isabelburgos/glasgow-rgmii-adapter/design.md

## Connectors

### RJ45

| P/N | Digikey | JLC
|--|--|--|
| RJMG201K21120FR | [link](https://www.digikey.com/en/products/detail/amphenol-cs-commercial-products/RJMG201K21120FR/13683222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) | [link](https://jlcpcb.com/partdetail/AmphenolICC-RJMG201K21120FR/C3179446)

### 2x10 Pin Receptacles

| P/N | Digikey | JLC
|--|--|--|
|BCS-110-S-D-TE|[link](https://www.digikey.com/en/products/detail/samtec-inc/BCS-110-S-D-TE/6629089)|--
|B-2200S20P-B120|--|[link](https://jlcpcb.com/partdetail/125694-B_2200S20PB120/C124419)

Added the following lines to positions.csv:
```
J1A,164.0,-80.95,90.0,top
J1B,164.0,-119.05,270.0,top
```

## 25 MHz

### Oscillator
| P/N | Digikey | JLC
|--|--|--|
|SG-210STF 25.0000ML0
|OT201625MJBA4SL

### Crystal
| P/N | Digikey | JLC
|--|--|--|
|ECS-250-10-37B-CTN-TR

## Passives

### Ferrite Beads
| P/N | Digikey | JLC
|--|--|--|
|BLM18PG300SN1D|--|[link](https://jlcpcb.com/partdetail/MurataElectronics-BLM18PG300SN1D/C17305)
