isabelburgos/glasgow-rgmii-adapter/glasgow ethernet adapter/3D models/ECS-250-10-37B-CTN-TR.step

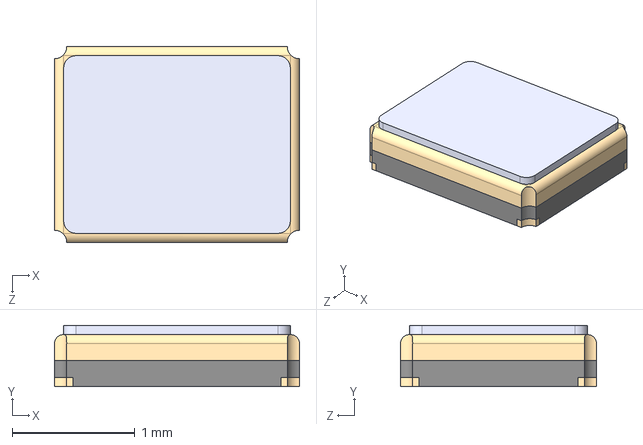
[picture p1: CAD file, 2025-06-25]
glasgow ethernet adapter/3D models/ECS-250-10-37B-CTN-TR.step
2.00 x 0.5 x 1.60 mm
