isabelburgos/glasgow-rgmii-adapter/glasgow ethernet adapter/3D models/SFH11-PBPC-D10-ST-BK.step

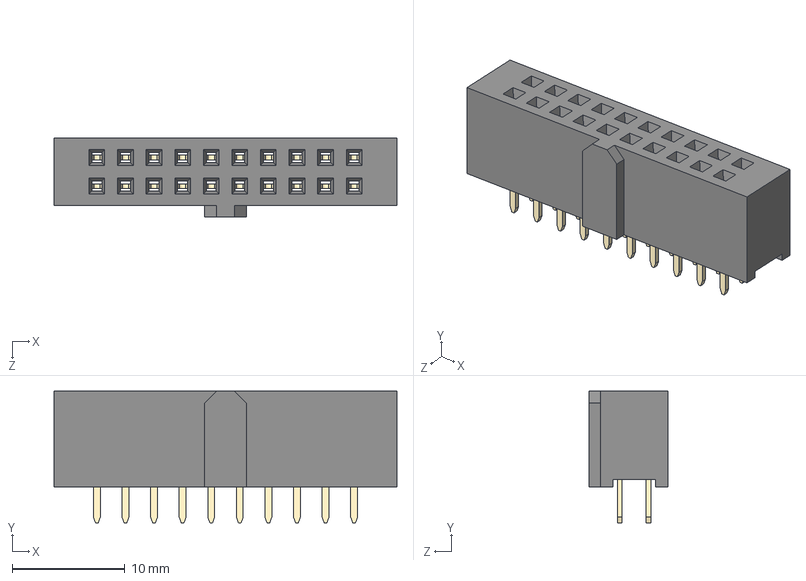
[picture p2: CAD file, 2025-06-25]
glasgow ethernet adapter/3D models/SFH11-PBPC-D10-ST-BK.step
30.5 x 11.7 x 7.01 mm
SFH11-xC-Dx-ST-BK body_10
pin^SFH11-xC-Dx-ST-BK Ass x 20
