isabelburgos/glasgow-rgmii-adapter/glasgow ethernet adapter/3D models/RJMG1S8008101BR.step

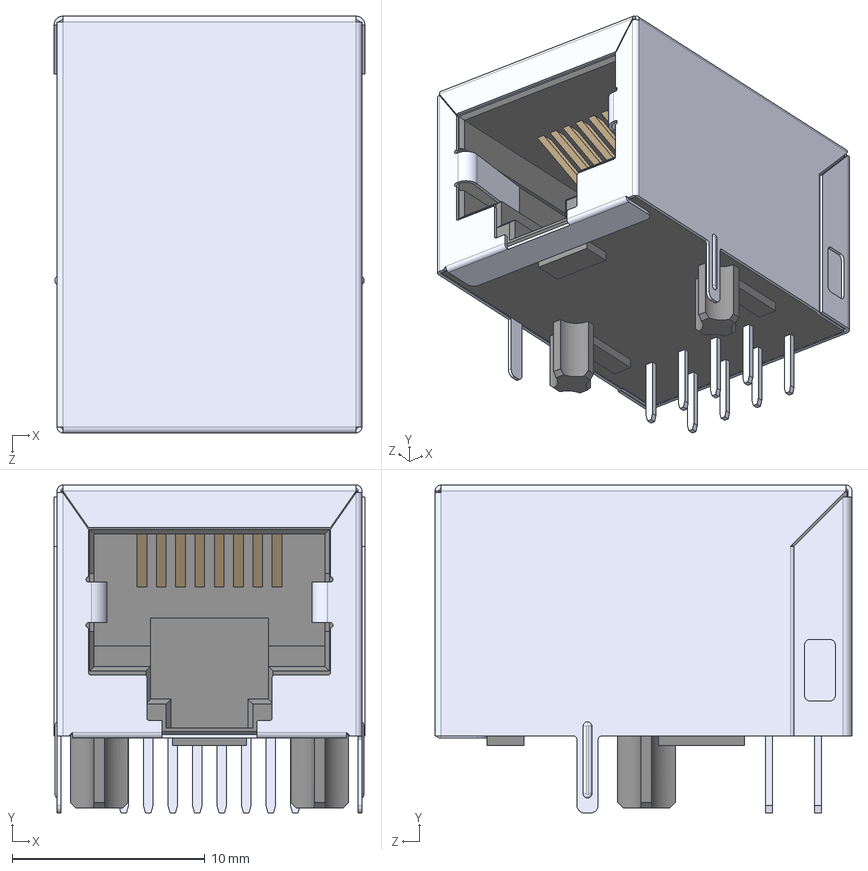
[picture p3: CAD file, 2025-06-25]
glasgow ethernet adapter/3D models/RJMG1S8008101BR.step
16.1 x 17.0 x 21.6 mm
