isabelburgos/glasgow-rgmii-adapter/glasgow ethernet adapter/glasgow ethernet adapter.kicad_pcb

## KiCad design glasgow ethernet adapter/glasgow ethernet adapter.kicad_pcb (2025-07-08)

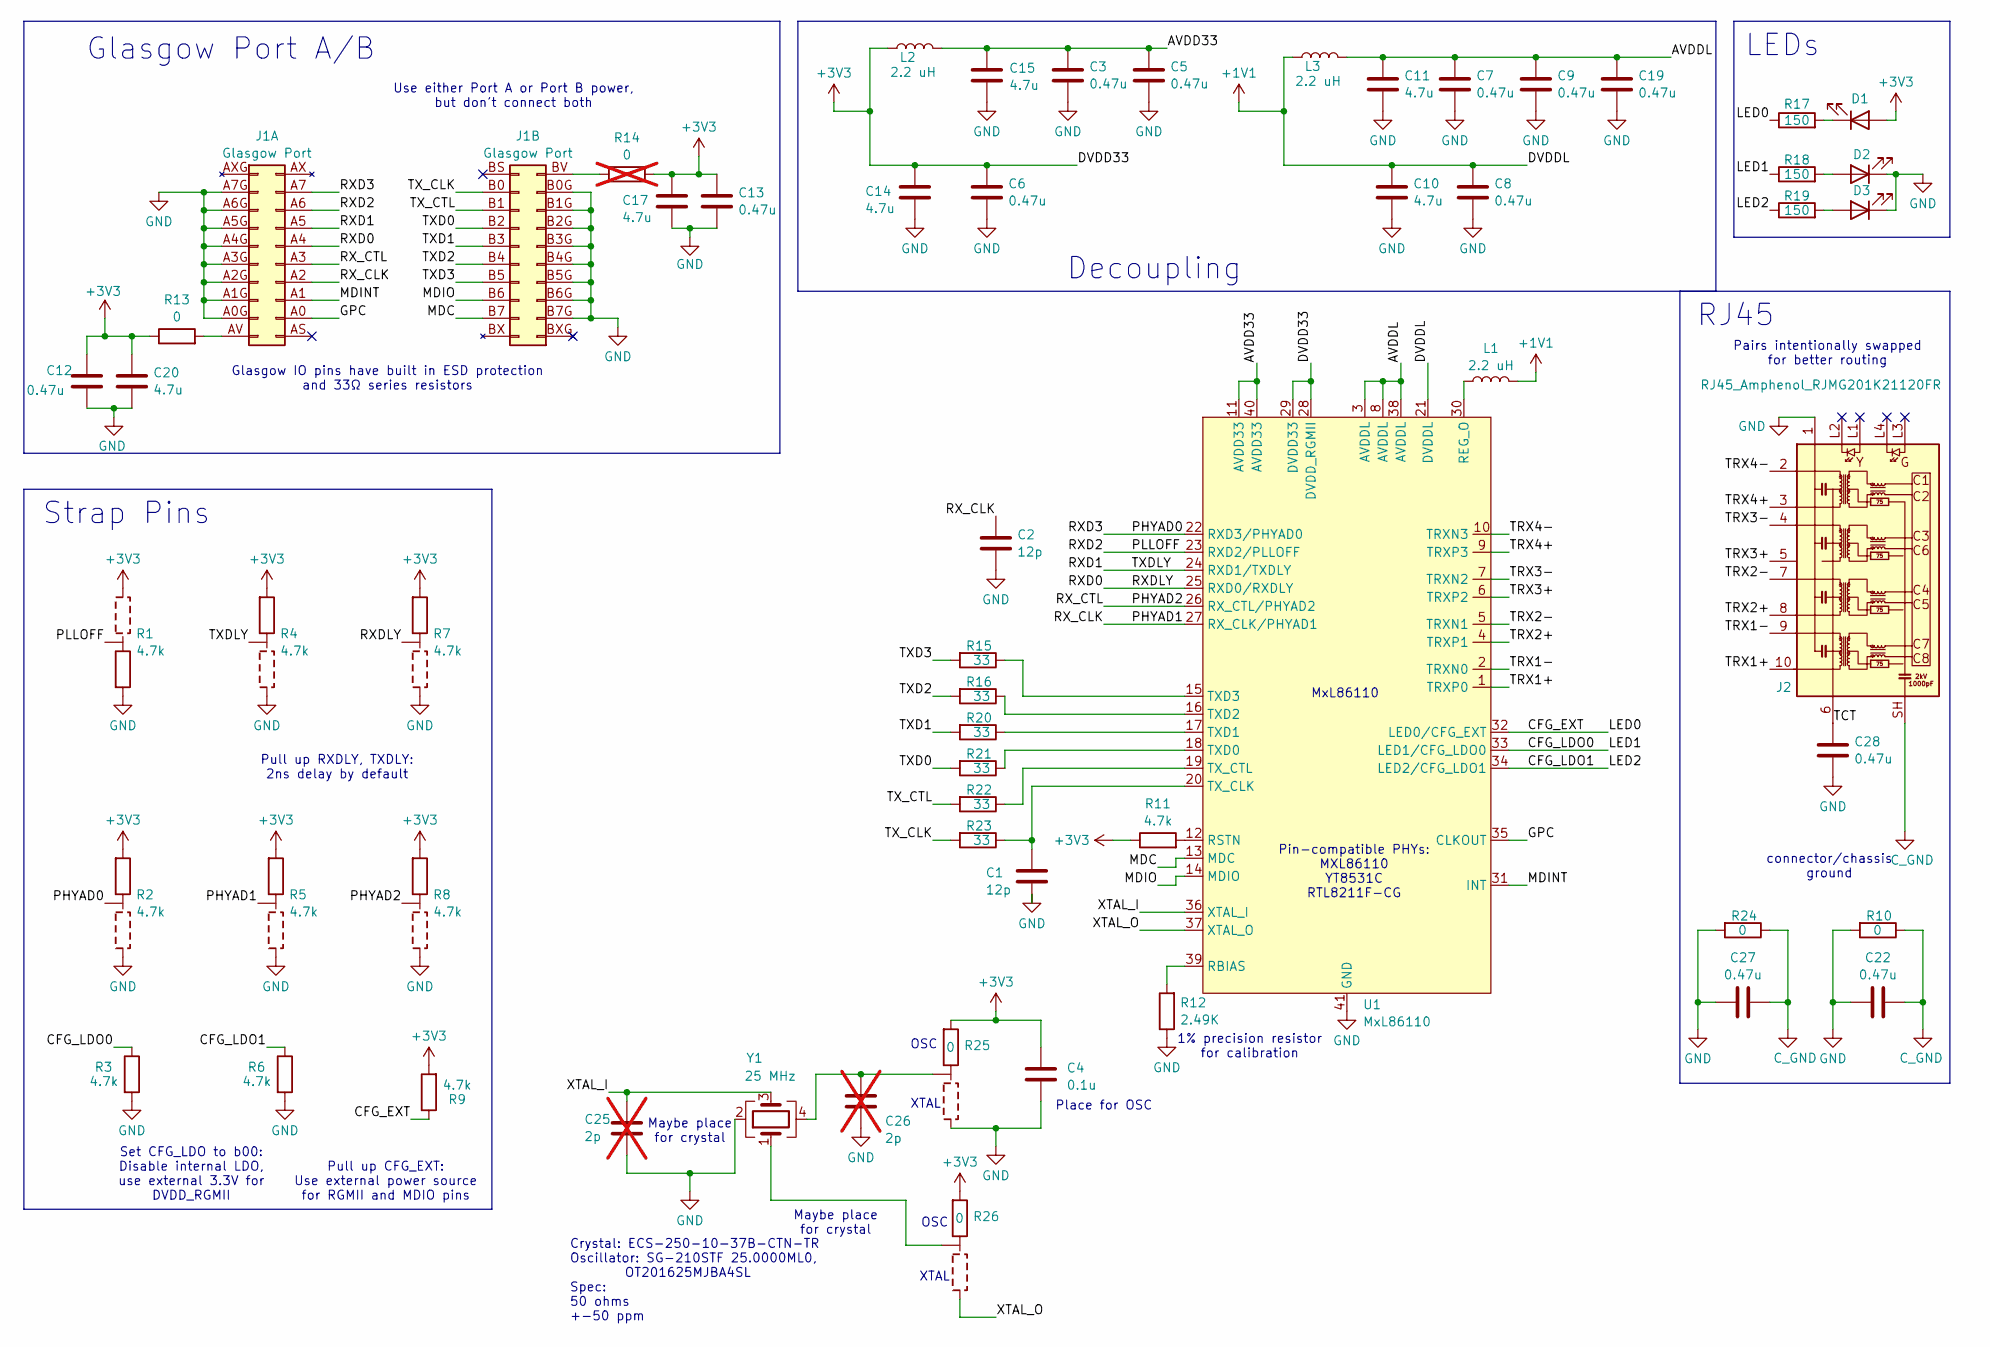
[picture p4: schematic glasgow ethernet adapter.kicad_sch]

Parts:
C1, C2: 12p; C_0402_1005Metric
C3, C5, C6, C7, C8, C9, C12, C13, C19, C22, C27, C28: 0.47u; C_0402_1005Metric
C4: 0.1u; C_0402_1005Metric
C10, C11, C14, C15, C17, C20: 4.7u; C_1206_3216Metric
C25, C26: 2p; C_0402_1005Metric; not fitted
D1, D2, D3: LED; D_0603_1608Metric
J1: Glasgow Port; Glasgow
J2: RJ45_Amphenol_RJMG201K21120FR; AMPHENOL_RJMG201K21120FR
L1, L2, L3: 2.2 uH; L_0603_1608Metric
R1, R2, R4, R5, R7, R8: 4.7k; R-3-Way_0402_1005Metric
R3, R6, R9, R11: 4.7k; R_0402_1005Metric
R10, R24: 0; R_0402_1005Metric
R12: 2.49K; R_0402_1005Metric
R13: 0; R_0603_1608Metric
R14: 0; R_0603_1608Metric; not fitted
R15, R16, R20, R21, R22, R23: 33; R_0402_1005Metric
R17, R18, R19: 150; R_0402_1005Metric
R25, R26: 0; R-3-Way_0402_1005Metric
U1: MxL86110; QFN-40-1EP_5x5mm_P0.4mm_EP3.8x3.8mm
Y1: 25 MHz; XTAL_ECS-160-9-37-CKM-TR

Connections:
+1V1: C8.1, C10.1, L1.2, L3.1, U1.21 (DVDDL)
+3V3: C4.1, C6.1, C12.1, C13.1, C14.1, C17.1, C20.1, D1.2 (A), L2.1, R1.3, R2.1, R4.1, R5.1, R7.1, R8.1, R9.2, R11.1, R13.1, R14.1, R25.1, R26.1, U1.28 (DVDD_RGMII), U1.29 (DVDD33)
/AVDD33: C3.1, C5.1, C15.1, L2.2, U1.11 (AVDD33), U1.40 (AVDD33)
/AVDDL: C7.1, C9.1, C11.1, C19.1, L3.2, U1.3 (AVDDL), U1.8 (AVDDL), U1.38 (AVDDL)
/CFG_EXT: R9.1, R17.1, U1.32 (LED0/CFG_EXT)
/CFG_LDO0: R3.1, R18.1, U1.33 (LED1/CFG_LDO0)
/CFG_LDO1: R6.1, R19.1, U1.34 (LED2/CFG_LDO1)
/GPC: J1.A0, U1.35 (CLKOUT)
/MDC: J1.B7, U1.13 (MDC)
/MDINT: J1.A1, U1.31 (INT)
/MDIO: J1.B6, U1.14 (MDIO)
/PHYAD0: J1.A7, R2.2, U1.22 (RXD3/PHYAD0)
/PHYAD1: C2.1, J1.A2, R5.2, U1.27 (RX_CLK/PHYAD1)
/PHYAD2: J1.A3, R8.2, U1.26 (RX_CTL/PHYAD2)
/PLLOFF: J1.A6, R1.2, U1.23 (RXD2/PLLOFF)
/RXD0: J1.A4, R7.2, U1.25 (RXD0/RXDLY)
/RXD1: J1.A5, R4.2, U1.24 (RXD1/TXDLY)
/TCT: C28.1, J2.6 (TCT)
/TRX1+: J2.10 (TD4-), U1.1 (TRXP0)
/TRX1-: J2.9 (TD4+), U1.2 (TRXN0)
/TRX2+: J2.8 (TD3-), U1.4 (TRXP1)
/TRX2-: J2.7 (TD3+), U1.5 (TRXN1)
/TRX3+: J2.5 (TD2-), U1.6 (TRXP2)
/TRX3-: J2.4 (TD2+), U1.7 (TRXN2)
/TRX4+: J2.3 (TD1-), U1.9 (TRXP3)
/TRX4-: J2.2 (TD1+), U1.10 (TRXN3)
/TXD0: J1.B2, R21.2
/TXD1: J1.B3, R20.2
/TXD2: J1.B4, R16.2
/TXD3: J1.B5, R15.2
/TX_CLK: J1.B0, R23.2
/TX_CTL: J1.B1, R22.2
/XTAL_I: C25.1, U1.36 (XTAL_I), Y1.3
/XTAL_O: R26.3, U1.37 (XTAL_O)
C_GND: C22.1, C27.1, J2.SH, R10.1, R24.1
GND: C1.2, C2.2, C3.2, C4.2, C5.2, C6.2, C7.2, C8.2, C9.2, C10.2, C11.2, C12.2, C13.2, C14.2, C15.2, C17.2, C19.2, C20.2, C22.2, C25.2, C26.2, C27.2, C28.2, D2.1 (K), D3.1 (K), J1.A0G, J1.A1G, J1.A2G, J1.A3G, J1.A4G, J1.A5G, J1.A6G, J1.A7G, J1.B0G, J1.B1G, J1.B2G, J1.B3G, J1.B4G, J1.B5G, J1.B6G, J1.B7G, J2.1 (GND), R1.1, R2.3, R3.2, R4.3, R5.3, R6.2, R7.3, R8.3, R10.2, R12.1, R24.2, R25.3, U1.41 (GND), Y1.2
unnamed: C26.1, R25.2, Y1.4
unnamed: D1.1 (K), R17.2
unnamed: D2.2 (A), R18.2
unnamed: D3.2 (A), R19.2
unnamed: J1.AV, R13.2
unnamed: J1.BV, R14.2
unnamed: R26.2, Y1.1
unnamed: R12.2, U1.39 (RBIAS)
unnamed: L1.1, U1.30 (REG_O)
unnamed: R11.2, U1.12 (RSTN)
unnamed: R21.1, U1.18 (TXD0)
unnamed: R20.1, U1.17 (TXD1)
unnamed: R16.1, U1.16 (TXD2)
unnamed: R15.1, U1.15 (TXD3)
unnamed: C1.1, R23.1, U1.20 (TX_CLK)
unnamed: R22.1, U1.19 (TX_CTL)

Notes on the sheet:
OSC
Strap Pins
Pairs intentionally swapped for better routing
Maybe place for crystal
MxL86110
Pull up RXDLY, TXDLY: 2ns delay by default
Use either Port A or Port B power, but don't connect both
connector/chassis ground
Set CFG_LDO to b00: Disable internal LDO, use external 3.3V for DVDD_RGMII
Pull up CFG_EXT: Use external power source for RGMII and MDIO pins
XTAL
Place for OSC
1% precision resistor for calibration
Decoupling
Pin-compatible PHYs: MXL86110 YT8531C RTL8211F-CG
Glasgow Port A/B
RJ45
Glasgow IO pins have built in ESD protection and 33Ω series resistors
Crystal: ECS-250-10-37B-CTN-TR Oscillator: SG-210STF 25.0000ML0, OT201625MJBA4SL Spec: 50 ohms +-50 ppm
LEDs

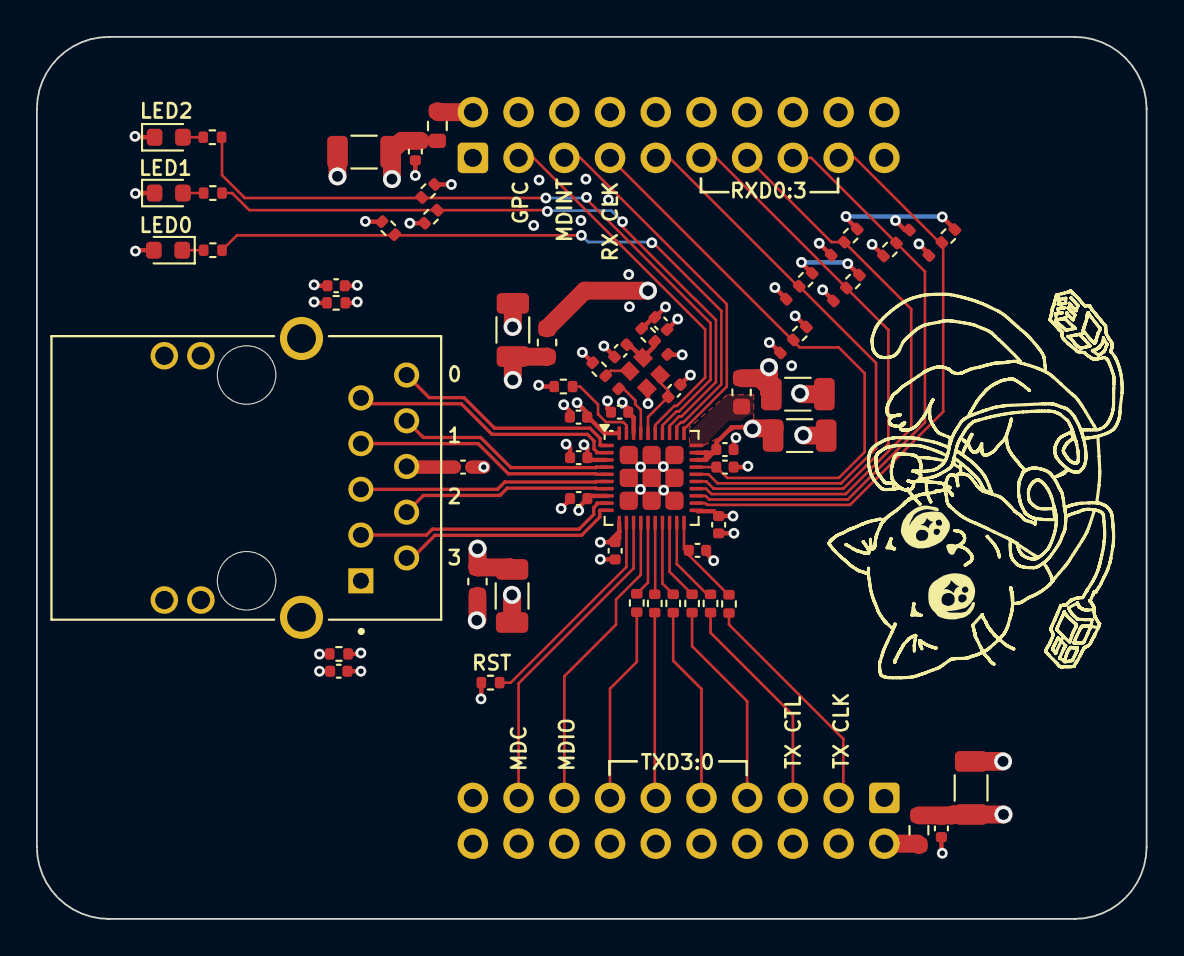
[picture p5: board glasgow ethernet adapter.kicad_pcb from above]

Board: 4 copper layers, 61.7 x 49.0 mm, 59 parts (0 on the bottom side), 52 nets.
