isabelburgos/glasgow-rgmii-adapter/(commit log)

2024-05-25 add transformer + protoype layout for transformer
    [glasgow ethernet adapter.kicad_sch]
2024-05-25 add link to KSZ9031RNZ die reference photo
2025-06-25 wip - connect MDC, add crystal
    [ECS-250-10-37B-CTN-TR.step, glasgow ethernet adapter.kicad_pcb, glasgow ethernet adapter.kicad_sch]
2025-06-25 wip - add 4-pair RJ45, switch to 4 layers
    [glasgow ethernet adapter.kicad_pcb, glasgow ethernet adapter.kicad_sch]
2025-06-26 wip - add silkscreen
    [glasgow ethernet adapter.kicad_pcb, glasgow ethernet adapter.kicad_sch]
2025-06-26 move strap resistors closer to PHY
    [glasgow ethernet adapter.kicad_pcb]
2025-06-26 length match RGMII traces
    [glasgow ethernet adapter.kicad_pcb, glasgow ethernet adapter.kicad_sch]
2025-06-26 length match diff pairs
    [glasgow ethernet adapter.kicad_pcb]
2025-06-27 misc fixes and DRC
    [glasgow ethernet adapter.kicad_pcb]
2025-07-01 add capacitors to crystal
    [glasgow ethernet adapter.kicad_pcb, glasgow ethernet adapter.kicad_sch]
2025-07-04 swap and re-route pairs
    [glasgow ethernet adapter.kicad_pcb, glasgow ethernet adapter.kicad_sch]
2025-07-04 simply ground transformer center tap
    [glasgow ethernet adapter.kicad_pcb, glasgow ethernet adapter.kicad_sch]
2025-07-04 squash back to 2 layers
    [glasgow ethernet adapter.kicad_pcb, glasgow ethernet adapter.kicad_sch]
2025-07-04 add oscillator compatible layout
    [glasgow ethernet adapter.kicad_pcb, glasgow ethernet adapter.kicad_sch]
2025-07-05 go back to 4 layers
    [glasgow ethernet adapter.kicad_pcb, glasgow ethernet adapter.kicad_sch]
2025-07-05 redo power + decoupling
    [glasgow ethernet adapter.kicad_pcb, glasgow ethernet adapter.kicad_sch]
2025-07-05 remove configurable pulls on LEDs
    [glasgow ethernet adapter.kicad_pcb, glasgow ethernet adapter.kicad_sch]
2025-07-06 move things around
    [glasgow ethernet adapter.kicad_pcb]
2025-07-07 increase fab tolerances, DRC fixes
    [glasgow ethernet adapter.kicad_pcb]
2025-07-08 export fab outputs, add note on parts sourcing
    [bom.csv, designators.csv, glasgow ethernet adapter.kicad_pcb, glasgow ethernet adapter.kicad_sch, positions.csv]
